yuvve/aeroponics/OpenHAB/conf/ui/readme.txt

# OpenHAB UI Configuration

File-based YAML definitions in this directory are not automatically loaded into OpenHAB.

## Manual Import Steps
1. Navigate to OpenHAB's UI page management
2. Create a new page
3. Switch to the page's Code editor
4. Copy and paste the YAML content from the files in this directory
