yuvve/aeroponics/ESPHome/README.md

# ESPHome

1. Install ESPHome on your machine
2. Copy `.secrets-example.yaml` into `secrets.yaml` and fill in the values.
3. Run `esphome dashboard <path-to-repo>/ESPHome`

## Flashing

To flash a microcontroller:

1. (first time flashing each microcontroller) connect the microcontroller to the machine running ESPHome and flash them by using choosing "Plug into the computer running ESPHome device builder".
5. From now on you can reflash the microcontroller via Wi-Fi.
