yuvve/aeroponics/docs/branch-example.png

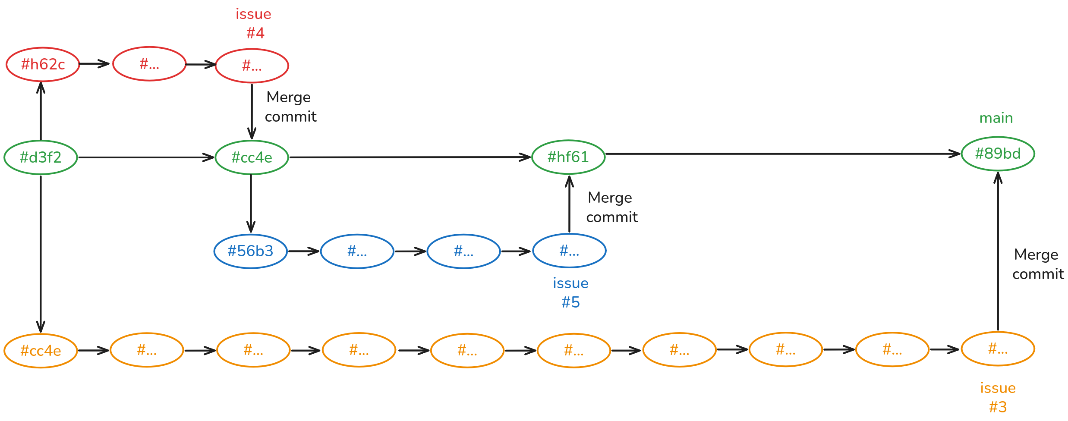
docs/branch-example.png
