yuvve/aeroponics/docs/communication-diagram.png

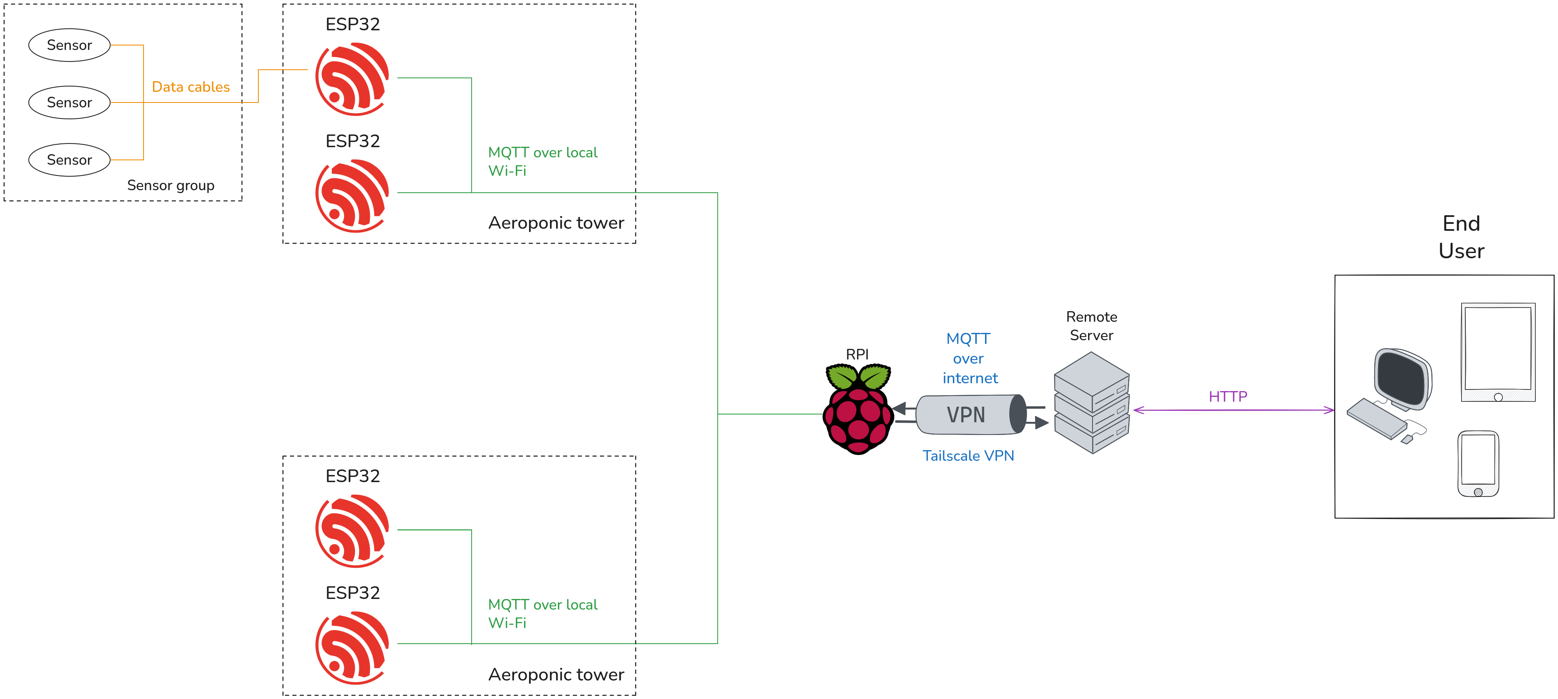
docs/communication-diagram.png
