yuvve/aeroponics/docs/diagrams/microcontroller/microcontroller.png

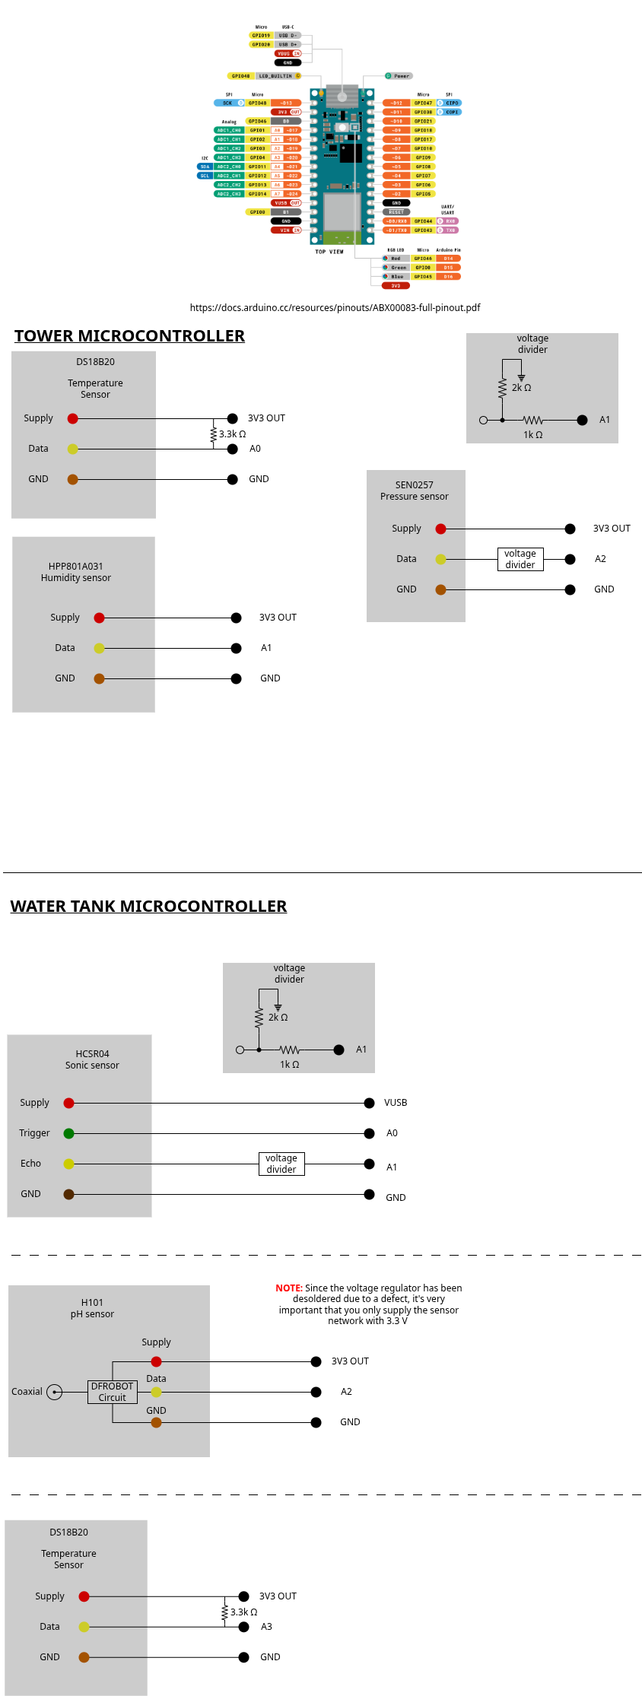
docs/diagrams/microcontroller/microcontroller.png
