yuvve/aeroponics/docs/diagrams/water_distribution.png

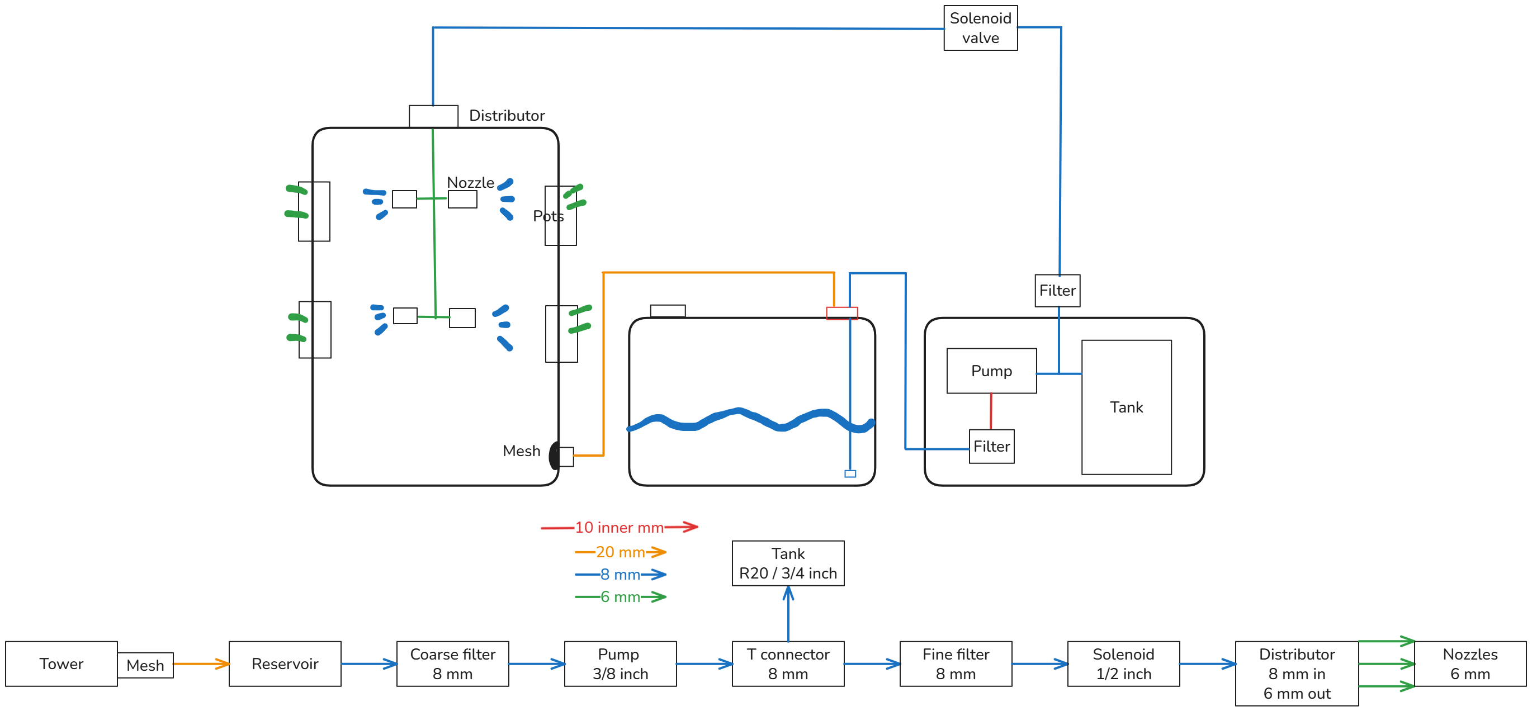
docs/diagrams/water_distribution.png
