yuvve/aeroponics/docs/git-workflow.png

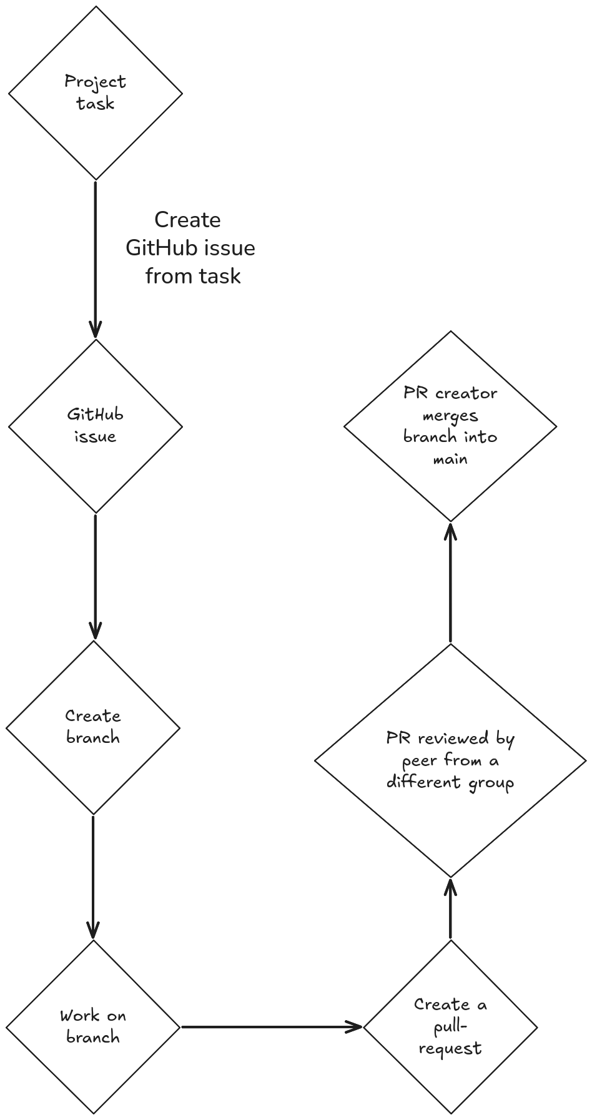
docs/git-workflow.png
