yuvve/aeroponics/docs/mqtt-diagram.png

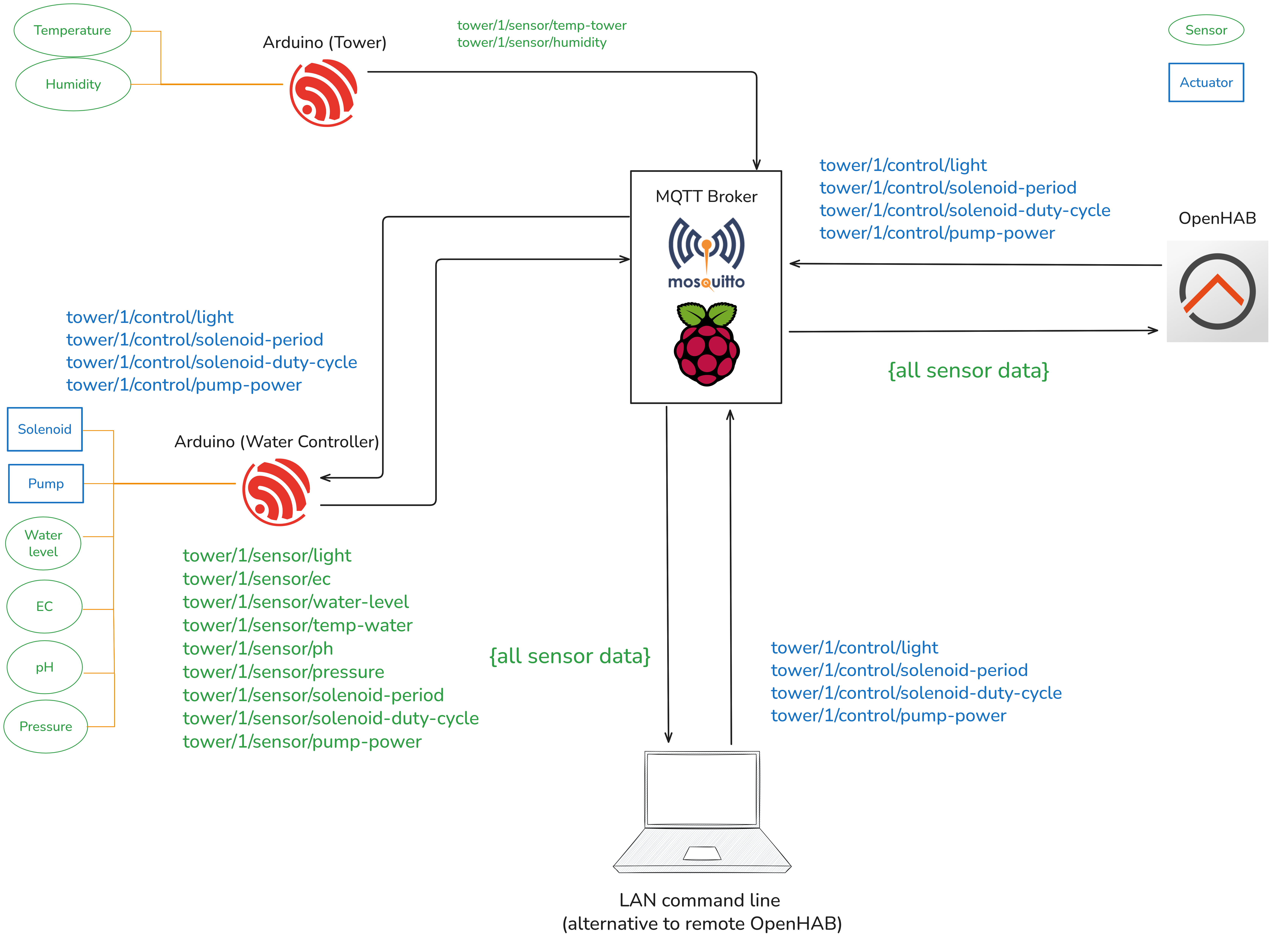
docs/mqtt-diagram.png
