yuvve/aeroponics/docs/sensor-diagrams/humidity_sensor/humidity_sensor_wheatstone_bridge_light_bg.png

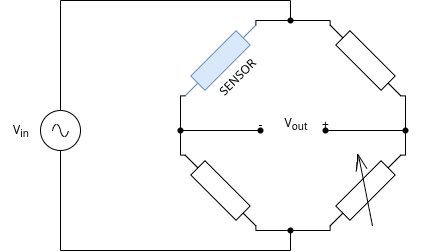
docs/sensor-diagrams/humidity_sensor/humidity_sensor_wheatstone_bridge_light_bg.png
