yuvve/aeroponics/docs/workflow.png

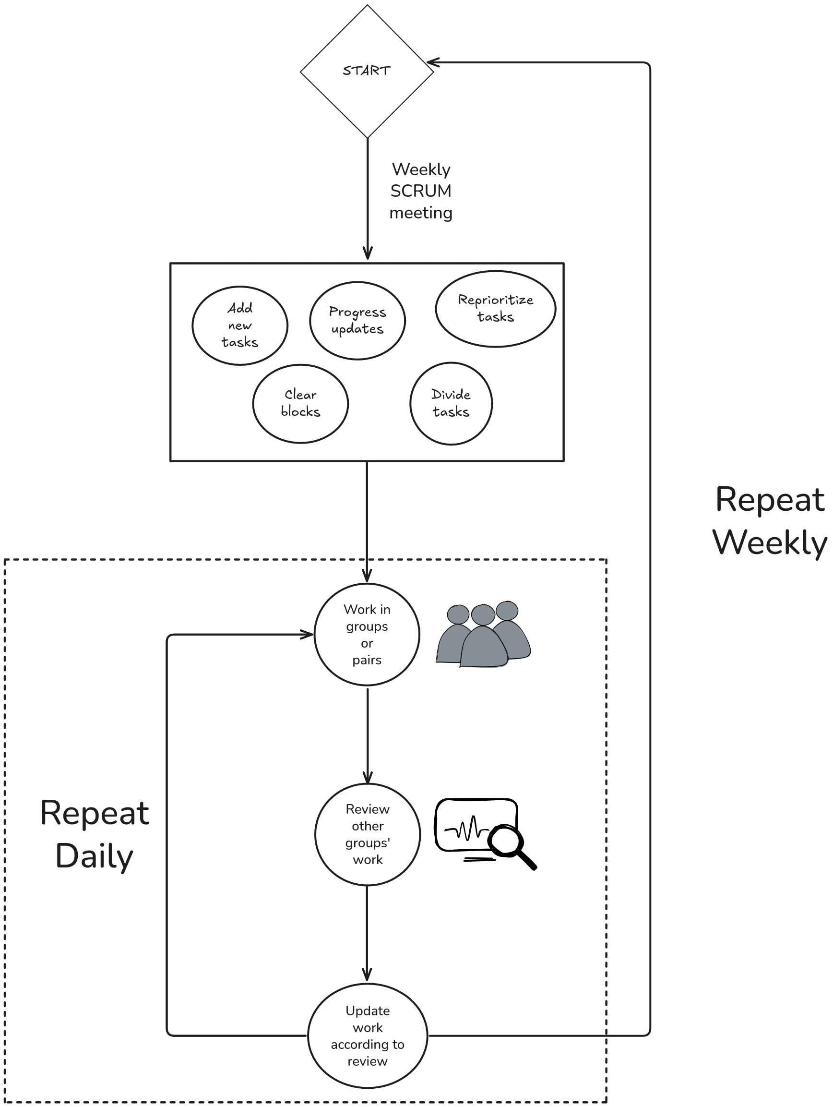
docs/workflow.png
