yuvve/aeroponics/Simulations/PROJEKTKURS.png

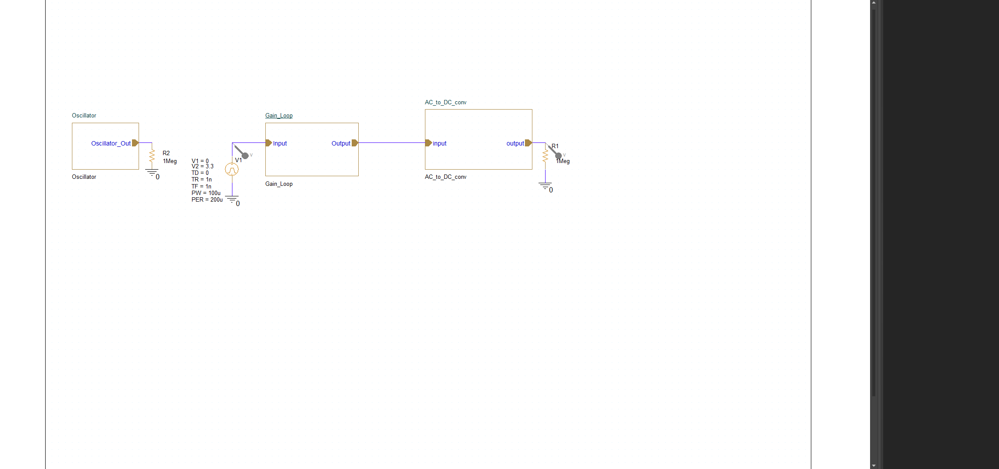
Simulations/PROJEKTKURS.png
