yuvve/aeroponics/docs/components/high-pressure-system.md

# High Pressure System

## Pump
- **Function:** Maintains water pressure (typically 80–120 psi).
- **Requirements:**
    - At least 100 psi operating pressure.
    - Preferably a diaphragm pump.
    - Food-safe materials: EPDM, Santoprene, Viton, PTFE.
    - Suitable for continuous use, or intermittent use with an accumulator.
    - Check valve.
    - Pressure switch.
- **Products:**
    - https://frenna.se/product.html/membranpump-61-lpm-24vdc-tryckvakt-69-bar-ce-nsf-shurflo-8000-853-238
        - [Data sheet](https://www.pumpagents.com/pdf/ShurfloPumps/8000-853-238.pdf)
      - [Good Pumps 100W](https://www.aliexpress.com/item/1005008111701489.html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)

## Misting Nozzles
- **Function:** Atomize water into fine droplets (around 45–55 µm).
- **Requirements:**
  - Stainless steel or ceramic for durability and ease of maintenance.
- **Products:**
    - **https://www.mrs-shop.com/micro-nebelduese-schnellverschraubung**    
        - [Data sheet](https://www.mrs-shop.com/media/pdf/33/56/12/micro-nebelduesen-uebersicht.pdf)
        - [Size chart](https://www.reddit.com/r/Hydroponics/comments/1i9yfze/mist_nozzle_and_pump_selection_chart_for/)
        - 0.5 mm opening: approx. 100ml/min, 95 degrees, 30-45 um.
        - NOTE: nozzles are included in 3 way fitting (see Tubing and Fittings)

## Pressure Tank (Accumulator)
- **Function:** Stabilizes pressure and reduces pump cycling.
- **Requirements:**
  - 2 L capacity.
  - Food-safe materials: EPDM, Santoprene, Viton, PTFE.
- **Products:**
  - https://billigtvvs.se/varme/expansionskarl/somatherm-expansionskarl-smf-for-solvarme-utan-ben-pn-10-2-liter/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

## Tubing and Fittings
- **Function:** Distribute water from the pump to the nozzles.
- **Requirements:**
    - Food-safe materials: PU, PE, PA (preferred).
    - Preferably black to prevent algae growth.
- **Products:**
    - [For nozzle distribution, 6 mm](https://www.mrs-shop.com/druckschlauch-6mm-schwarz-27bar)
    - [For mains (pump, tank), 8 mm](https://www.mrs-shop.com/druckschlauch-8mm-blau-12bar)
    - Fittings:
        - [Coarse filter (suction side)](https://www.mrs-shop.com/vorfilter-fuer-beregnungsanlagen-150my-siebfilter)
        - [Pump to 8mm hose (suction and pressure side)](https://www.mrs-shop.com/steckverschraubung-hochdruck-3/8-npt)
        - [T connector to pressure tank](https://www.mrs-shop.com/t-schnellverschraubung-mit-ueberwurfmutter-8/6mm)
        - [Pressure tank to hose (might need alternative)](https://www.mrs-shop.com/steckanschluss-innengewinde-6-8-12-mm)
        - [Fine filter (pressure side after pressure tank)](https://www.mrs-shop.com/filtersystem-fs-sd18-fuer-beregnungsanlagen)
        - [Supply distributor, manometer](https://www.mrs-shop.com/dreifach-schlauchverteiler-mit-manometeranzeige)
        - [3 way with included nozzles](https://www.mrs-shop.com/flexi-nebelduese-3fach)
        - [Adapter for solenoid valve, 1/2 inch to 8mm](https://www.mrs-shop.com/aufschraubverschraubung-mit-innengewinde-1/2-zoll) 
    - [Hose scissor](https://www.mrs-shop.com/rohrschere-6-20mm-kunststoffrohr)
 
## Reservoir
- **Function:** Stores the nutrient solution.
- **Requirements:**
  - All parts in contact with water should be food-safe.
  - Preferably black to prevent algae growth.
- **Products**
  - https://www.hembryggeriet.se/jaskarl-30-liter-med-lock-och-tappkran-393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
  - https://www.hydrogarden.se/produkter/odlingssystemkrukor/bevattning-pumpar/tropf-blumat-bevattningssystem/blumat-hink-20-liter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
  - https://supergrow.se/shop/efterbehandling/ekstraktion/vaskemaskiner-tilbehoer/spand-223-l-foedevaregodkendt/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
  - https://www.ajprodukter.se/lager-verkstad/avfallshantering-stad/avfallsbehallare/avfallskarl/plasttunna-med-lock-19111-19109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
  - https://supergrow.se/shop/efterbehandling/ekstraktion/vaskemaskiner-tilbehoer/spand-30-l-foedevaregodkendt/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
  - https://www.clasohlson.com/se/Hink-av-livsmedelsgodkand-plast,-10-liter,-Nordiska-plast/p/34-5020-1

## Solenoid Valve
- **Function:** Controls the flow of water to the nozzles and handles emptin of the tank for new water flow.
- **Requirements:**
  - Reasonable response time.
- **Products:**
  -  For disposal and mist (3 valve)
    - https://se.rs-online.com/web/p/solenoid-valves/1904145
    - https://se.rs-online.com/web/p/solenoid-valves/1904144
    - https://se.rs-online.com/web/p/solenoid-valves/7013378
  -  For single control of mist and water input (2 valve)
      - [RS PRO Solenoid Valve, 2 port(s) , NC, 24 V ac/dc, 1/2in ](https://se.rs-online.com/web/p/solenoid-valves/1904135?gb=s)

## General System Requirements
- All (or most) parts in contact with water must use food-safe materials.
- Maximum system pressure should be above 150 psi (10 bar) for a safety margin.
