yuvve/aeroponics/docs/parts/sensors/conductivity/four_prong_ec_sensor_diagram.png

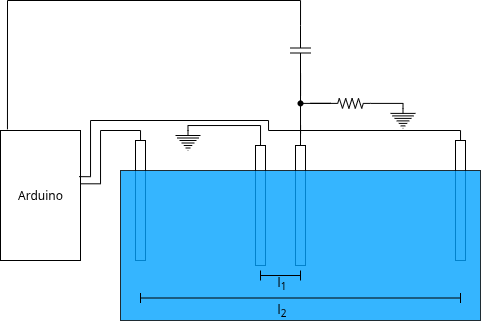
docs/parts/sensors/conductivity/four_prong_ec_sensor_diagram.png
