yuvve/aeroponics/docs/power-wiring-diagrams/power_diagram.drawio.png

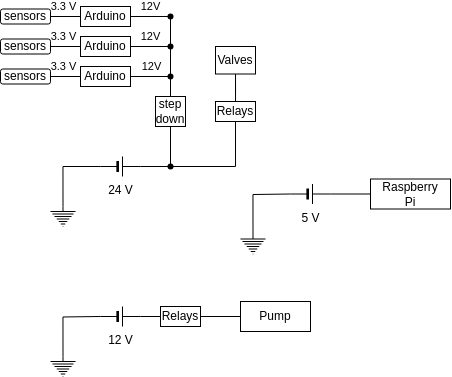
docs/power-wiring-diagrams/power_diagram.drawio.png
