yuvve/aeroponics/docs/fmea/fmea.ods

Process Copmonent | Potential Failure Mode | Potential Failure Effect | SEV | Potential Causes | OCC | Current Process Controls | DET | RPN | Recommended Actions
Which component or step of the process is the source of the failure? | What kinds of failures can be expected from the component or process step? | Impact if the failure is not rectified? | How severe is the failure? | What causes the failure? | How frequently is the failure likely to occur? | Modes of failure occurence/detection | How likely is it that the failure is not detected? | Risk priority number (SEV times OCC times DET) | What actions are recommended to reduce the occurrence or improve its detection?
Hoses and seals | Leakage | Not enough pressure to the nozzles, resulting in potential loss of operation | 8 | Degrading material | 2 | Pressure sensors | 1 | 16 | Regular inspection of the hoses and the sealants
 | Clamping |  |  | Human error |  | Leakage |  |  | Reviewing each others work, more eyes during assembly
 |  |  |  | Faulty equipment on delivery |  |  |  |  | Use reputable vendors, test and verify functionality before entrusting them
Pressure sensor | Malfunction | No mode of detection of hoses/seals failure | 4 | Faulty equipment on delivery | 6 |  | 4 | 96
 |  |  |  | Incorrect calibration |  |  |  |  | Test sensor in regular intervals
 | Incorrect pressure reporting |  |  | Software bugs
Temperature sensor | Malfunction | Nothing | 0 | Faulty equipment on delivery | 3 |  | 3 | 0
 |  |  |  | Incorrect calibration |  |  |  |  | Test sensor in regular intervals
 | Incorrect temperature reporting |  |  | Software bugs
Humidity sensor | Malfunction | Solenoid will open in unknown situations | 5 | Faulty equipment on delivery | 6 | Solenoid opening uncontrollably | 2 | 60
 |  |  |  | Incorrect calibration |  | Pump running during wrong intervals |  |  | Test sensor in regular intervals
 | Incorrect humidity reporting |  |  | Software bugs
Tank |  | Water will leak | 8 |  | 2 |  | 1 | 16
 | Leakage |  |  | Degrading material |  | Leakage |  |  | Patch leakages
Microcontrollers | Malfunction | All sensors and system will break | 8 | Faulty equipment on delivery | 5 |  | 2 | 80
 |  |  |  | Power failure |  | Entire system is running uncontrollably |  |  | Alerts
 | Entire system failure |  |  | Software bugs
Power supply |  | System will be off and plants may die | 4 | Faulty equipment on delivery | 3 |  | 4 | 48
 | System turns off |  |  | Power outage |  | Everything is off |  |  | Try to keep the power on
Valve (solenoid) | Malfunction | Plants will not be watered | 4 | Faulty equipment on delivery | 4 |  | 4 | 64
 |  |  |  |  |  |  |  |  | Test sensor in regular intervals
 | Nozzles will not supply water to plants |  |  | Software bugs
Nozzles | Malfunction | Plants will not be watered | 4 | Faulty equipment on delivery | 6 |  | 4 | 96
 | Nozzles will not supply water to plants |  |  | Degrading material
PH-sensor | Malfunction | Nothing | 0 | Faulty equipment on delivery | 6 |  | 4 | 0
 |  |  |  | Incorrect calibration
 | Incorrect PH reporting |  |  | Software bugs
j
