yuvve/aeroponics/(list of files, drawings)

Other design files:
Simulations/DESIGN1.DSN
Simulations/Design1.opj
Simulations/Projektkurs.dsn
Simulations/Projektkurs.opj
