yuvve/aeroponics/design/buck-converter/kicad/buck-converter.kicad_pcb

## KiCad design design/buck-converter/kicad/buck-converter.kicad_pcb (2026-01-12)

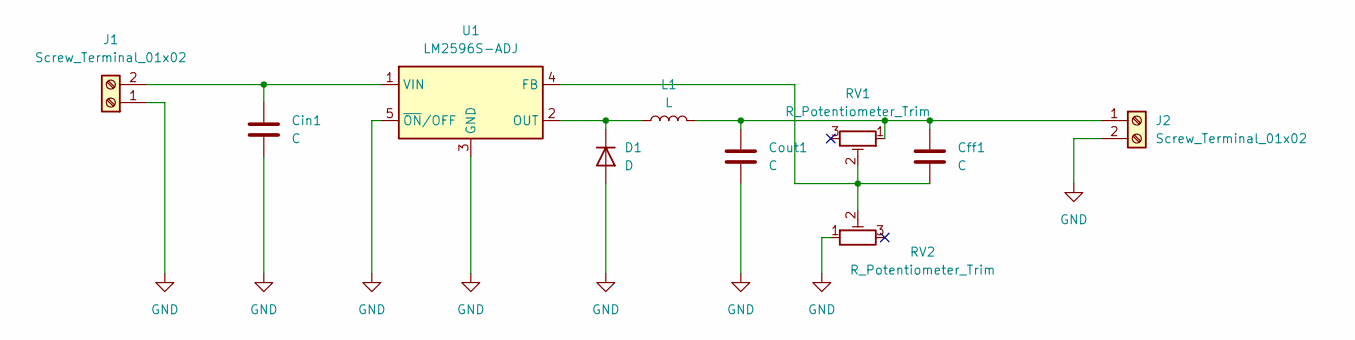
[picture p12: schematic buck-converter.kicad_sch]

Parts:
Cff1: C; TPME158K004R0015
Cin1: C; TPME158K004R0015
Cout1: C; TPME158K004R0015
D1: D; MBRS360T3G
J1, J2: Screw_Terminal_01x02; terminal-block-2-pole-TB006-508-02BE
L1: L; 36561040M101T
RV1, RV2: R_Potentiometer_Trim; Potentiometer_Bourns_3314J_Vertical
U1: LM2596S-ADJ; TO-263-5_TabPin3

Connections:
GND: Cin1.2, Cout1.2, D1.2 (A), J1.1, J2.2, RV2.1, U1.3 (GND), U1.5 (~ON/OFF)
unnamed: D1.1 (K), L1.1, U1.2 (OUT)
unnamed: Cin1.1, J1.2, U1.1 (VIN)
unnamed: Cff1.1, Cout1.1, J2.1, L1.2, RV1.1
unnamed: Cff1.2, RV1.2, RV2.2, U1.4 (FB)

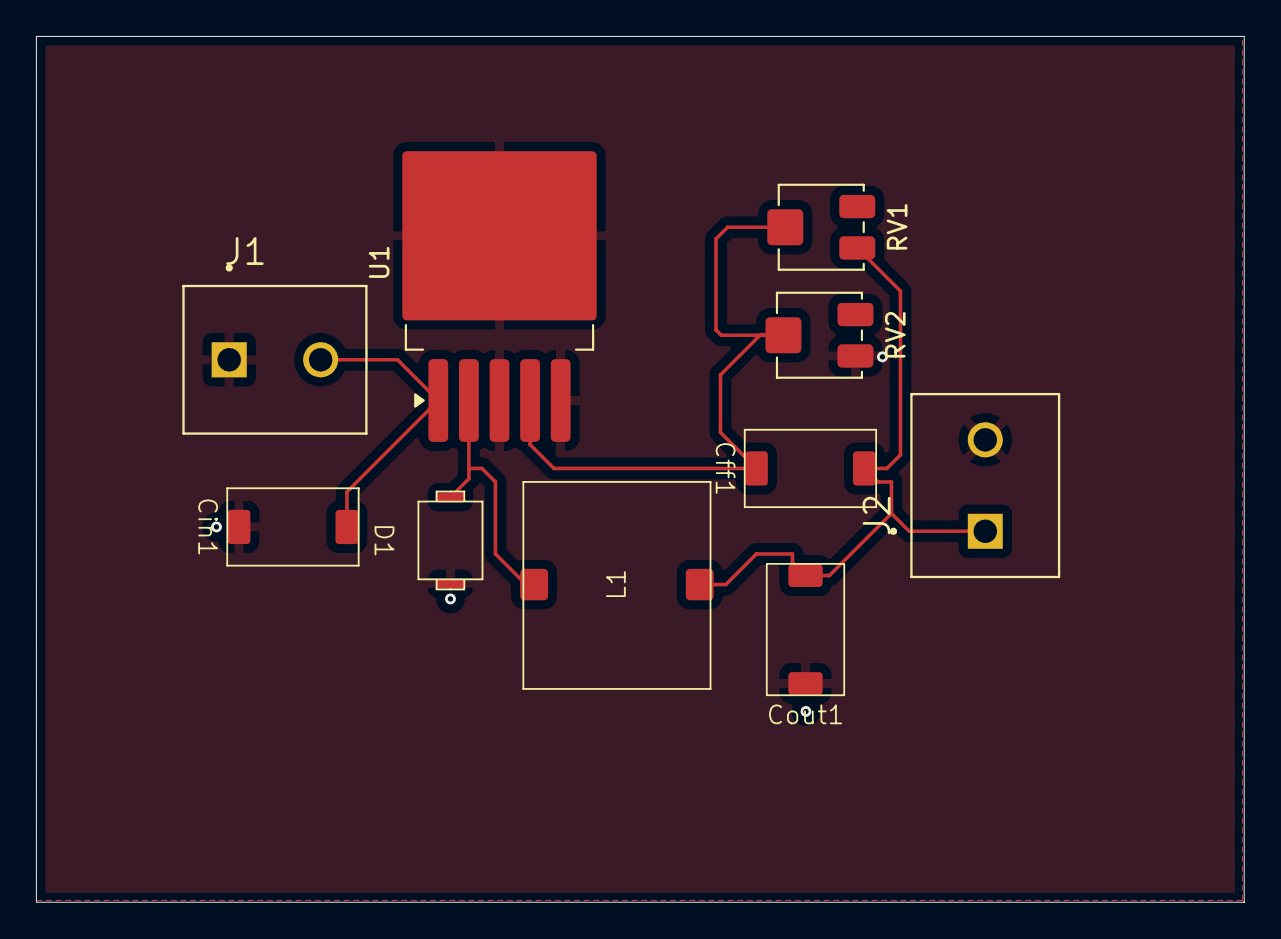
[picture p13: board buck-converter.kicad_pcb from above]

Board: 2 copper layers, 67.1 x 48.1 mm, 10 parts (0 on the bottom side), 5 nets.
