yuvve/aeroponics/arduino/PlatformIO/humidity-sensor/src/main.cpp

#include "Arduino.h"

const int pin = A0;
volatile unsigned long counter = 0;
unsigned long prev_t = 0;
float freq = 0.0;
const int sample_t = 1000; // ms
char buffer[256];

void countPulses() // For use in interrupt
{
	counter++;
}

void setup()
{
	Serial.begin(9600);
	pinMode(pin, INPUT);
	attachInterrupt(digitalPinToInterrupt(pin), countPulses, RISING);
}

void loop()
{
	unsigned long t = millis();
	if(t - prev_t >= sample_t)
	{
		freq = (float)counter/(float)(t - prev_t)*1e3f;
		counter = 0;
		prev_t = t;
		sprintf(buffer, "Frequency: %f\r\n", freq);
		Serial.print(buffer);
	}
}
