yuvve/aeroponics/(commit log)

2025-09-24 8 choose high pressure equipment (#35)
    * Add pump and tubing suggestions
    * Add nozzle
    Updated the documentation to replace 'Alternatives' with 'Products' and added relevant product links.
    * Update high-pressure system documentation with new link
    Added product link for micro line quick nozzles in Germany.
    * Update product links in high-pressure system documentation
    Added new product links and updated existing ones for clarity.
    * Update specifications and links in high-pressure system doc
    * Added some 3 and 2 valves to the list of options
    * Added some potential valves, accumulators and reservoirs
    * Update high-pressure-system.md
    * Revise high-pressure system documentation with new p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
2025-09-24 10 choose sensors (#39)
    * Create sensors.md
    Requirements, ideas, datasheets, etc.
    * Added preliminary purchasing list
    * Added first batch purchasing list
    * Update sensors.md
    * Update sensors.md
    ---------
2025-10-10 37 power wiring diagram (#45)
    * Added diagram for power wiring.
    * Added power diagrams.
    * Added wheatstone bridge diagram.
    * Restructured content.
    * Updated diagrams
    Removed signal wires and added the Raspberry Pi to the diagram with a separate power supply.
    * Update sensor diagrams
    Updated sensor diagrams in accordance with the PR review.
    Ref: #45
    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
2025-11-09 31 create remote server (#53)
    * Initial commit for remote server and mosquitto
    * Fix gitignore
    * Add ESPHome
    * Ignore esphome data folder, change secrets example name
    * Add ESPHome readme
    * Remove OpenHAB docker, add symlink to conf folder instead
    * Fix wrong symlink direction
    * Update ESPHome
    * Add tower 1 item yaml definitions
    * Add missing MQTT broker config
    * Replace DSL with YAML, add channels
    * Remove clientid from mqtt broker definition
    * Use tailscale magic DNS instead of IP in mqtt broker config
    * Add item-channel links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
    [addons.cfg, basicui.cfg, influxdb.cfg, rrd4j.cfg, runtime.cfg]
2025-11-11 Add additional solenoid actuator and clarify names (#61)
2025-11-28 60 work on UI openhab dashboard (#62)
    * Add overview UI
    * Fix item units
    * Fix humidity UI label
    * Fix channel name mismatch
    * Add unit to EC
    * Update alert ranges
    [overview.yaml]
2025-12-23 68 implement alerts (#70)
    * Add alerts to yaml config
    * Fix wrong label
    * Fix wrong Dimension name
    * Update overview.yaml
    * Add alerts toggle
    * Add all alerts
    * Fix missing tower number in description
    * Fix wrong trigger variable
    * Fix bad automation rules
    * Fix EC sensor wrong dimension and wrong names in automation scripts
    [overview.yaml]
2026-01-11 57 create esphome code from platformio examples (#69)
    * Add water-level sensor
    * Add temp lower sensor
    * Add solenoid and pump sensor/control
    * Fix solenoid and pump MQTT payload
    * Add pressure delay and watchdog
    * Add tower sensors
    * Add ph sensor
    * Update MQTT topics: Upper -> Tower
    * Add humidity sensor
    * Add pressure sensor
    * Fix pump delay sequence
    * Add test yaml
    * Add ph reading using internal ADC
    * Reduce humidity interval
    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
    [water.yaml]
2026-01-11 Add mqtt diagram (#51)
    * Add mqtt diagram
    * MQTT tower1 -> tower/1, actuator -> control, add sensors for actuators status
    * Remove lower tower from mqtt diagram
    * Add additional solenoid actuator and clarify names
    * Fix 'sensor' instead of 'control'
    * Update mqtt diagram
    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
2026-01-11 16 program microcontrollers (#74)
    * Add sonic-sensor.ino
    Added first draft of sonic sensor Arduino code to get the distance (for
    the water level measurement in the water tank).
    * Update sonic sensor
    Restructured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
2026-01-11 63 perform failure mode and effects analysis fmea (#75)
    * Add fmea.ods
    Added FMEA template.
    * Add files via upload
    * fmpa
    * Fix conditional formatting and formulas
    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
    [fmea.ods]
2026-01-11 54 create microcontroller diagrams (#76)
    * Update diagrams
    Made microcontroller diagrams
    * Update microcontroller.png
    Updated microcontroller.png and microcontroller.drawio
    * Update microcontroller.png
    Fixed supply values and added note about pH sensor.
    * Update microcontroller.png
    * Update microcontroller.png
2026-01-11 49 design ec sensor (#77)
    * Add ec sensor diagrams
    * Update ec sensor diagrams
    * Add four prong ec sensor diagram
    * Initial commit of EC sensor simulation files
    * Update README with EC sensor current state
    Added current state information about the EC sensor and its specifications.
    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
    [DESIGN1.DSN, Design1.opj, Projektkurs.dsn, Projektkurs.opj]
2026-01-12 64 create kicad file for buck converter (#78)
    * Create buck-converter directory
    KiCad initial creation
    * Added files via upload
    * Update buck-converter kicad
    * Create footprint
    Create footprint for 36561040M101T SMD inductor
    * Add TPME158K004R0015.kicad_mod
    Added a footprint for the tantalum low ESR capacitor from KYOCERA AVX
    * Add MBRS360T3G.kicad_mod
    Added a footprint for the MBRS360T3G low ESR capacitor
    * Add terminal-block-2-pole-TB006-508-02BE.kicad_mod
    Added a connector footprint, borrowed from the E7009E course room.
    * Update KiCad schematics
    Updated footprints, added PCB
    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
    [buck-converter.kicad_pcb, buck-converter.kicad_sch]
